besi/kicad-tcnd5000/tcnd5000.step

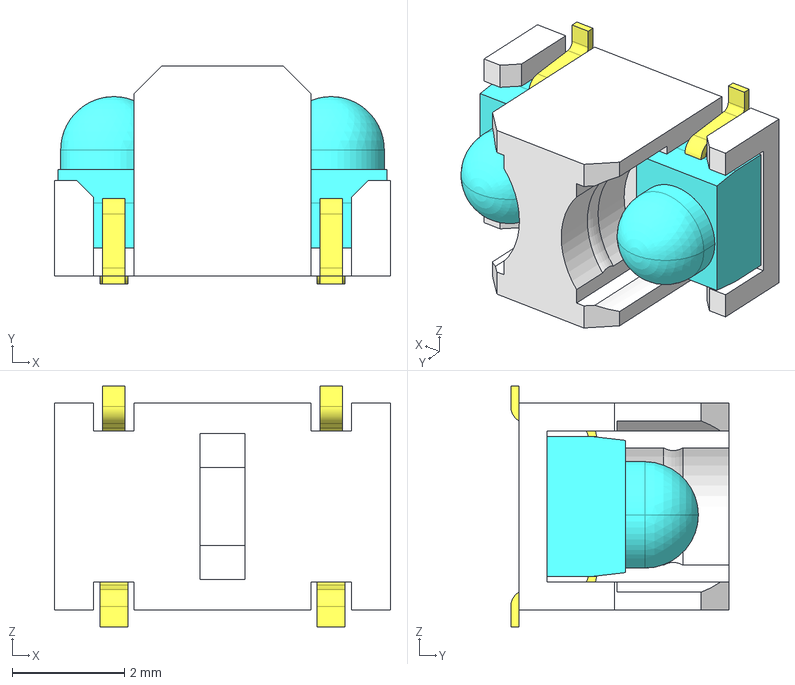
[picture p1: CAD file, 2023-12-03]
tcnd5000.step
6.00 x 3.90 x 4.30 mm
LED x 2
ANODE x 2
BEINCHEN x 2
HOUSING VAR 2
